eltech-online/eltech-esp32-mood-lamp/(commit log)

2026-10-06 Beta: firmware, wiring diagram and guide (compiles, not yet tested on hardware)
2026-10-06 Wiring diagram: tidier layout, smoother lines, parts on both sides of the wiring channel
2026-10-06 Wiring diagram: draw the parts as pictures instead of plain blocks
2026-10-06 Wiring diagram: draw the ESP32-C3 board too
2026-10-06 Wiring diagram: print every pin name on the ESP32-C3 board
2026-10-06 Wiring diagram: parts on the left of the wiring are turned round, so their pins read in the true order
2026-10-06 Wiring diagram: drop the beta note from the picture (the README carries it)
2026-10-12 Knob: follow both wires so contact bounce no longer steps the wrong way; wiring diagram and README use the pin order printed on the real parts
2026-10-13 Brightness: share the leftover colour step over time (ring redrawn 200 times a second) so dim mixed colours stay true and every LED matches; lowest level 3%; Breathe and Candle fade through the same 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
2026-10-13 Out of beta: built and tested on the bench, build badge in the README; more plain-language comments in the sketch (colour unpacking, dimming example, interrupts), MIN_BRIGHT_PCT as a named setting, R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
